namcho/PFC2k5W/Power/power_module.kicad_pcb

## KiCad design Power/power_module.kicad_pcb (2018-06-28)

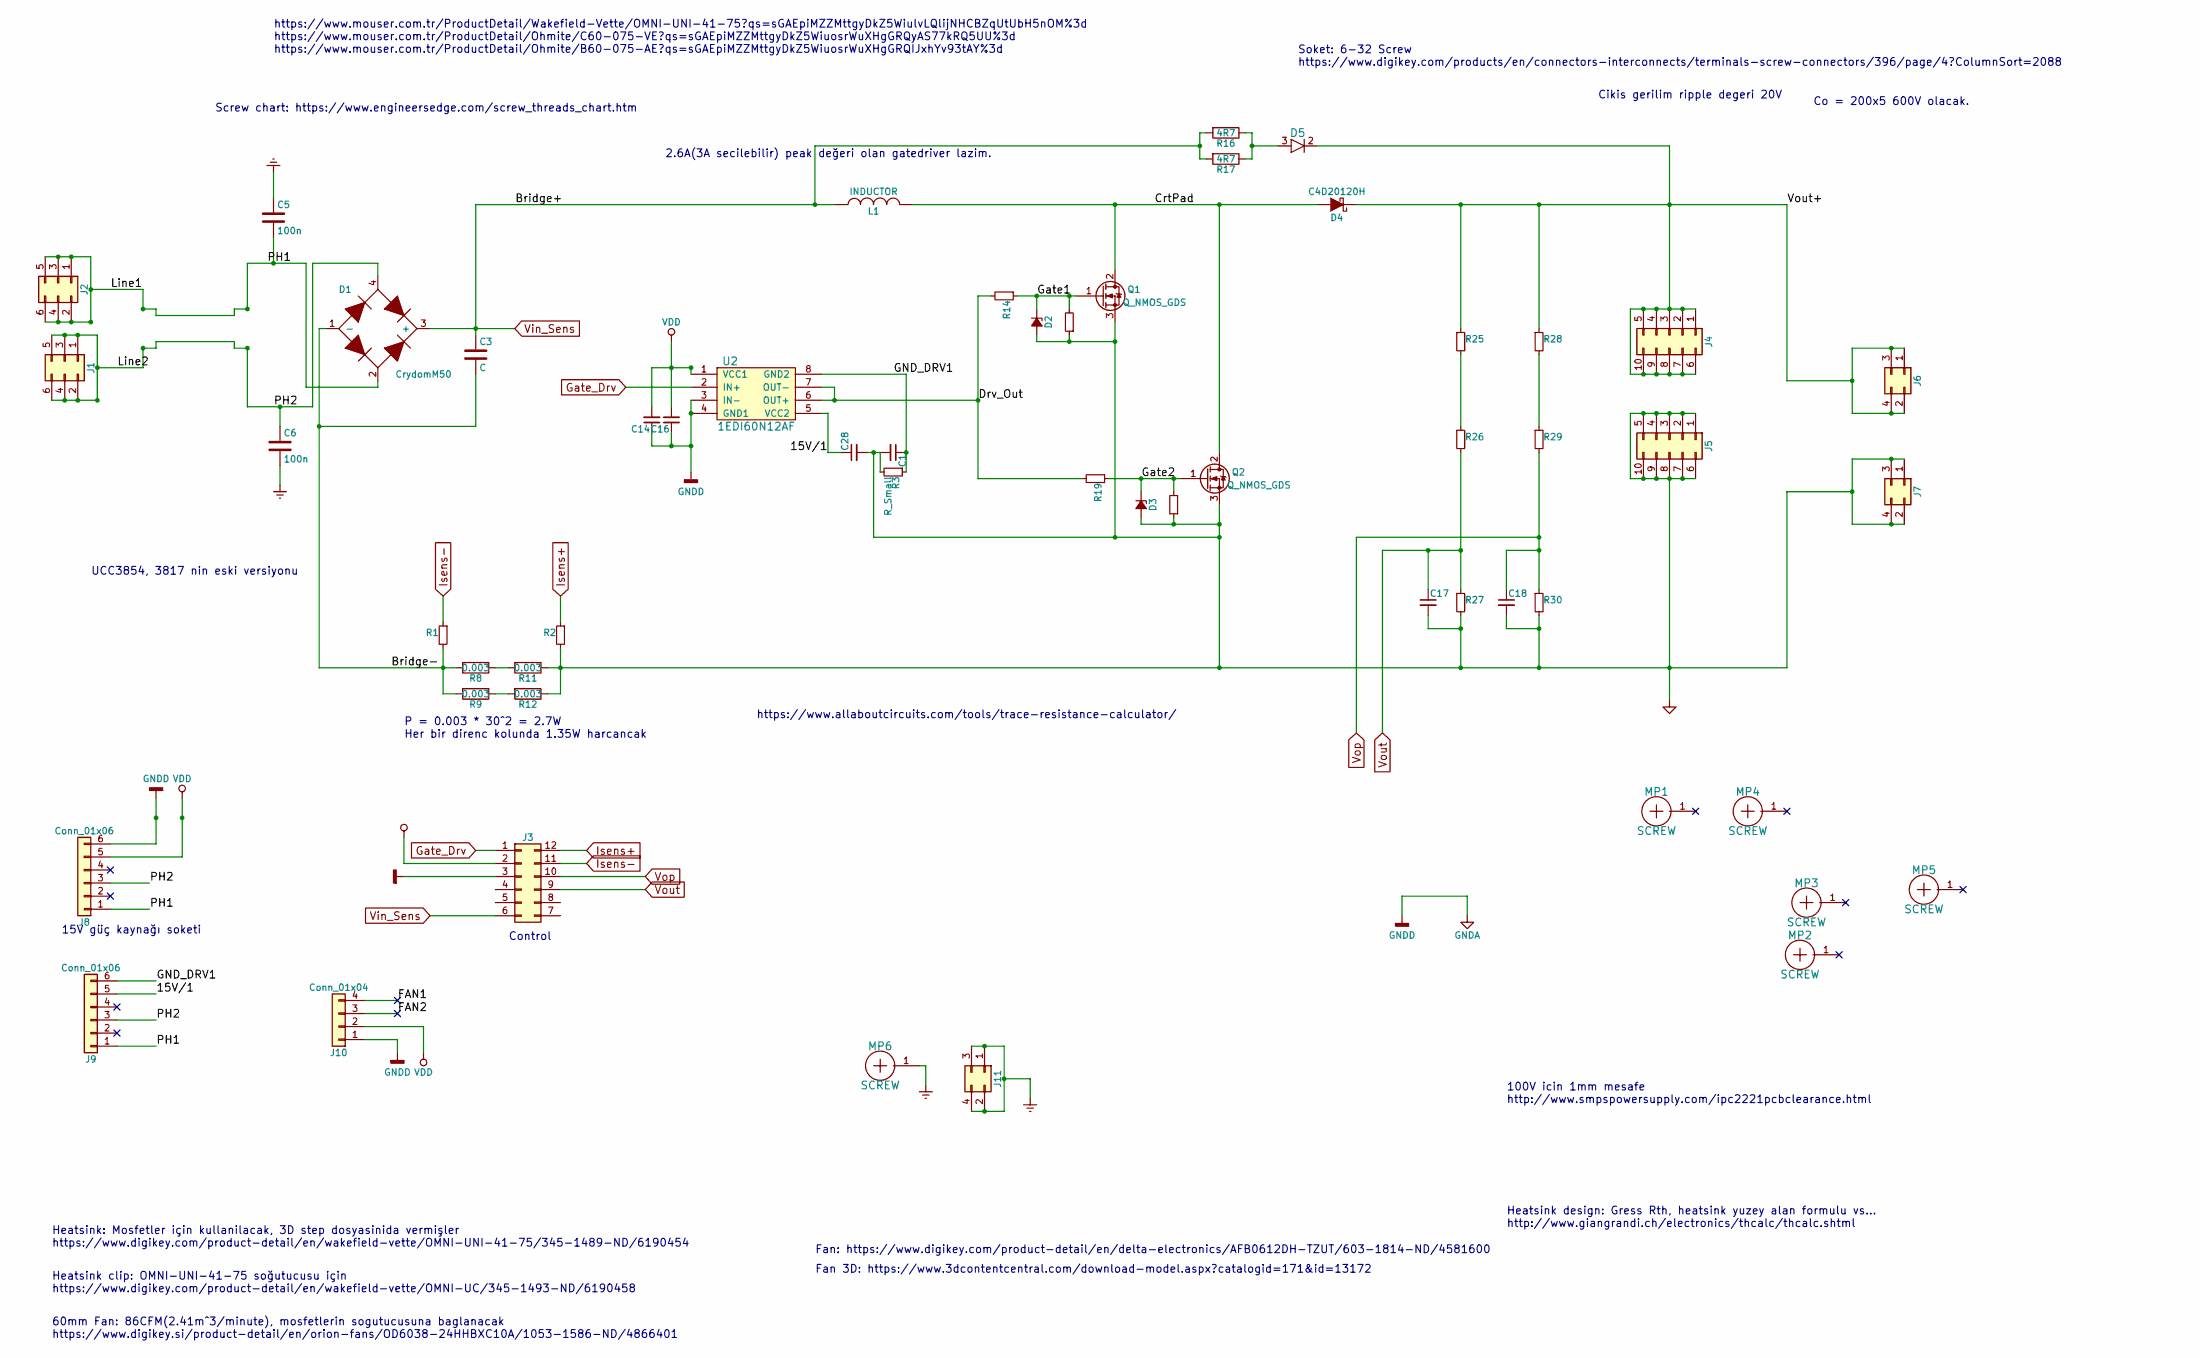
[picture p1: schematic power_module.sch]

Parts:
C1, C16, C28: 1u; C_1206_HandSoldering
C3: C; C_Rect_L18.0mm_W5.0mm_P15.00mm_FKS3_FKP3
C5, C6: 100n; C_Rect_L18.0mm_W8.0mm_P15.00mm_FKS3_FKP3
C14: 10n; C_0805_HandSoldering
C17, C18: C_Small; C_0805_HandSoldering
D1: CrydomM50; CrydomM50x_Fixed
D2, D3: D_Zener_Small_ALT; D_SOD-123
D4: C4D20120H; TO-247-2_Vertical
D5: IDW75E60; TO-247_TO-3P_Vertical
J1, J2: Conn_02x03_Odd_Even; Conn_6pins_30A
J3: Conn_02x06_Counter_Clockwise; Harwin_M55_6001242R
J4, J5: Conn_02x05_Top_Bottom; Hirose_FX30B_5P_DSA
J6, J7, J11: Conn_02x02_Odd_Even; Conn_4pins_15A
J8, J9: Conn_01x06; Pin_Header_Straight_1x06_Pitch2.54mm
J10: Conn_01x04; Pin_Header_Straight_1x04_Pitch2.54mm
L1: INDUCTOR; OD_77.80xID_39.34xHT_25.85_Vertical
MP1, MP2, MP3, MP4, MP5, MP6: SCREW; SCREW_3mm
Q1, Q2: Q_NMOS_GDS; TO-247_TO-3P_Vertical
R1, R2, R14, R19, R25, R26, R27, R28, R29, R30: R_Small; R_1206_HandSoldering
R3: R_Small; R_0805_HandSoldering
R8, R9, R11, R12: 0.003; R_2512_HandSoldering
R16, R17: 4R7; R_2512_HandSoldering
R31, R32: 10k; R_1206_HandSoldering
U2: 1EDI60N12AF; SOIC-8_3.9x4.9mm_Pitch1.27mm

Connections:
/15V/1: C28.1, J9.5, U2.5 (VCC2)
/Bridge-: C3.2, D1.1 (-), R1.2, R8.2, R9.2
/CrtPad: D4.2 (A), L1.1, Q1.2 (D), Q2.2 (D)
/Drv_Out: R14.2, R19.2, U2.6 (OUT+), U2.7 (OUT-)
/FAN1: J10.4
/FAN2: J10.3
/GND_DRV1: C1.1, J9.6, R3.1, U2.8 (GND2)
/Gate1: D2.1 (K), Q1.1 (G), R14.1, R31.2
/Gate2: D3.1 (K), Q2.1 (G), R19.1, R32.2
/Line1: C5.2, D1.2, J2.1, J2.2, J2.3, J2.4, J2.5, J2.6, J8.1, J9.1
/Line2: C6.1, D1.4, J1.1, J1.2, J1.3, J1.4, J1.5, J1.6, J8.3, J9.3
/Vout+: D4.1 (K), D5.2, J4.1, J4.2, J4.3, J4.4, J4.5, J4.6, J4.7, J4.8, J4.9, J4.10, J6.1, J6.2, J6.3, J6.4, R25.1, R28.1
Earth: C5.1, C6.2, J11.1, J11.2, J11.3, J11.4, MP6.1
GNDA: C1.2, C14.1, C16.1, C17.2, C18.2, C28.2, D2.2 (A), D3.2 (A), J3.3, J5.1, J5.2, J5.3, J5.4, J5.5, J5.6, J5.7, J5.8, J5.9, J5.10, J7.1, J7.2, J7.3, J7.4, J8.6, J10.1, Q1.3 (S), Q2.3 (S), R2.2, R3.2, R11.1, R12.1, R27.2, R30.2, R31.1, R32.1, U2.3 (IN-), U2.4 (GND1)
Gate_Drv: J3.1, U2.2 (IN+)
Isens+: J3.12, R2.1
Isens-: J3.11, R1.1
unnamed: D5.3, R16.1, R17.1
unnamed: R8.1, R11.2
unnamed: R9.1, R12.2
unnamed: R25.2, R26.1
unnamed: R28.2, R29.1
VDD: C14.2, C16.2, J3.2, J8.5, J10.2, U2.1 (VCC1)
Vin_Sens: C3.1, D1.3 (+), J3.6, L1.2, R16.2, R17.2
Vop: C18.1, J3.10, R29.2, R30.1
Vout: C17.1, J3.9, R26.2, R27.1

Notes on the sheet:
15V güç kaynağı soketi
Heatsink design: Gress Rth, heatsink yuzey alan formulu vs... http://www.giangrandi.ch/electronics/thcalc/thcalc.shtml
https://www.mouser.com.tr/ProductDetail/Wakefield-Vette/OMNI-UNI-41-75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 https://www.mouser.com.tr/ProductDetail/Ohmite/C60-075-VE?qs=sGAEpiMZZMttgyDkZ5WiuosrWuXHgGRQyAS77kRQ5UU%3d https://www.mouser.com.tr/ProductDetail/Ohmite/B60-075-AE?qs=sGAEpiMZZ…
60mm Fan: 86CFM(2.41m^3/minute), mosfetlerin sogutucusuna baglanacak https://www.digikey.si/product-detail/en/orion-fans/OD6038-24HHBXC10A/1053-1586-ND/4866401
Heatsink clip: OMNI-UNI-41-75 soğutucusu için https://www.digikey.com/product-detail/en/wakefield-vette/OMNI-UC/345-1493-ND/6190458
Heatsink: Mosfetler için kullanilacak, 3D step dosyasinida vermişler https://www.digikey.com/product-detail/en/wakefield-vette/OMNI-UNI-41-75/345-1489-ND/6190454
2.6A(3A secilebilir) peak değeri olan gatedriver lazim.
Screw chart: https://www.engineersedge.com/screw_threads_chart.htm
Fan: https://www.digikey.com/product-detail/en/delta-electronics/AFB0612DH-TZUT/603-1814-ND/4581600
Fan 3D: https://www.3dcontentcentral.com/download-model.aspx?catalogid=171&id=13172
Soket: 6-32 Screw https://www.digikey.com/products/en/connectors-interconnects/terminals-screw-connectors/396/page/4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
100V icin 1mm mesafe http://www.smpspowersupply.com/ipc2221pcbclearance.html
P = 0.003 * 30^2 = 2.7W Her bir direnc kolunda 1.35W harcancak
Cikis gerilim ripple degeri 20V
UCC3854, 3817 nin eski versiyonu
Co = 200x5 600V olacak.
Control
https://www.allaboutcircuits.com/tools/trace-resistance-calculator/

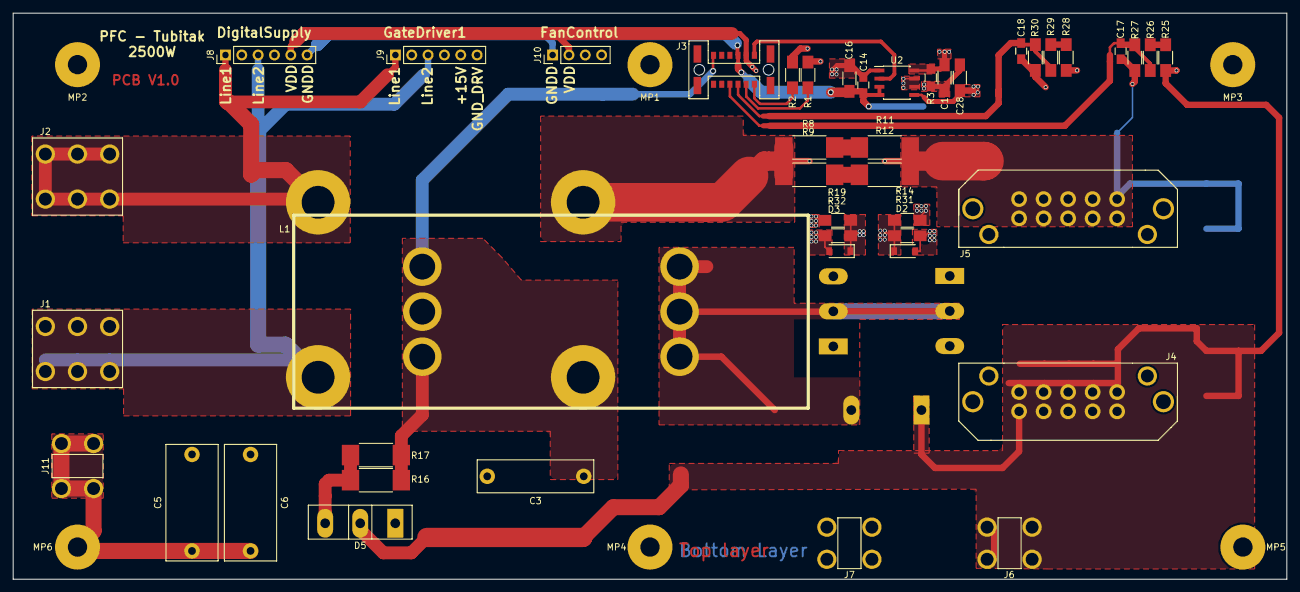
[picture p2: board power_module.kicad_pcb from above]

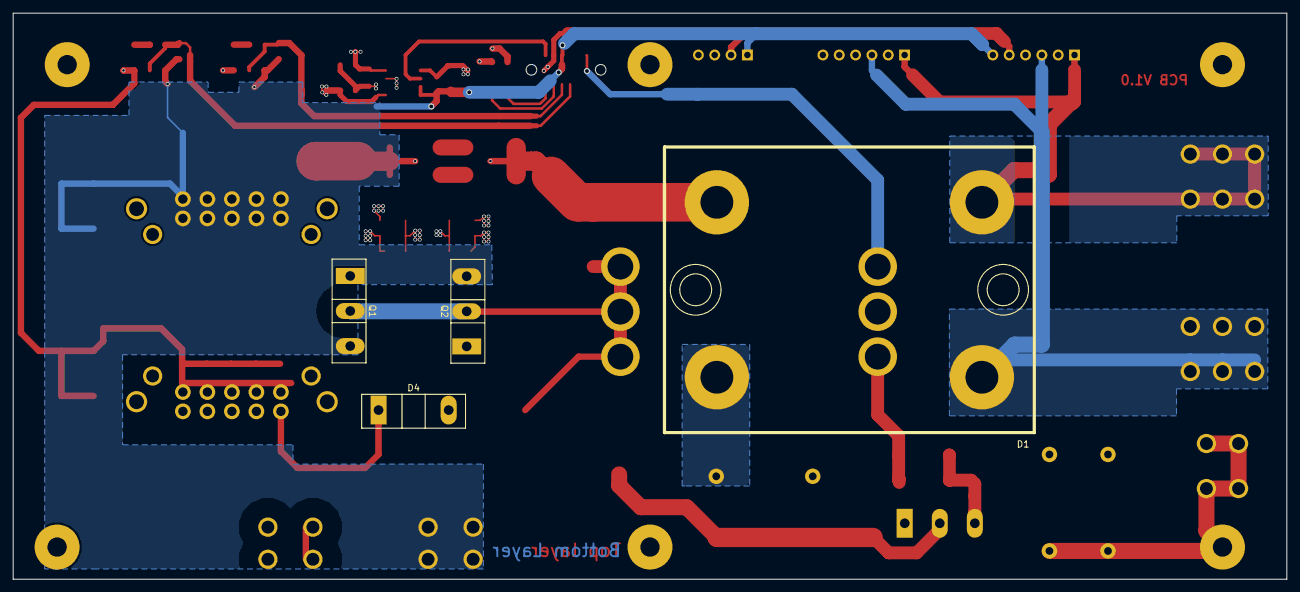
[picture p3: board power_module.kicad_pcb from below]

Board: 4 copper layers, 198.0 x 88.0 mm, 54 parts (4 on the bottom side), 24 nets.
