namcho/PFC2k5W/PFC2k5W.kicad_pcb

## KiCad design PFC2k5W.kicad_pcb (2018-05-13)

Schematic: PFC2k5W.sch

Parts:
C1, C13: 100u; CP_Elec_8x10
C2: 100n; C_0805_HandSoldering
C3: C; C_Rect_L10.0mm_W4.0mm_P7.50mm_MKS4
C4, C9: CP1_Small; C_1206_HandSoldering
C5, C6, C7, C8, C10, C11, C17, C18, C20: C_Small; C_0805_HandSoldering
C12, C16, C28: 1u; C_1206_HandSoldering
C14, C29: 10n; C_0805_HandSoldering
C15, C19: 250u; C_MKP_Vishay_70x65x57.5
D1: CrydomM50; CrydomM50x_Fixed
D2, D3: BAS40-00; SOT-23_Handsoldering
D4, D6, D8: ZENERsmall; D_SOD-123
D5: IDW75E60; TO-247_TO-3P_Vertical
D7: C5D50065D; TO-247_TO-3P_Vertical
L1: INDUCTOR_2; OD_77.80xID_39.34xHT_25.85_Horizantal
MP1, MP2, MP3, MP4, MP5, MP6: SCREW; SCREW_3mm
P1, P2: CONN_02X03; Conn_6pins_30A
P3, P6, P8: CONN_01X04; Pin_Header_Straight_1x04_Pitch2.54mm
P4, P5: CONN_02X02; Conn_4pins_15A
P7, P9: CONN_01X02; Pin_Header_Straight_1x02_Pitch2.54mm
Q1, Q2: Q_NMOS_GDS; TO-247_TO-3P_Vertical
Q3: IRF540N; TO-220
R1: 382k; R_1206_HandSoldering
R2: 383k; R_1206_HandSoldering
R3, R4, R5, R6, R7, R10, R13, R15, R20, R22, R23, R24, R33, R34, R35, R36, R37: R_Small; R_0805_HandSoldering
R8, R9, R11, R12: 0.003; R_2512_HandSoldering
R14, R19, R25, R26, R27, R28, R29, R30: R_Small; R_1206_HandSoldering
R16, R17: 4R7; R_2512_HandSoldering
R21: 0; R_0805_HandSoldering
R31, R32: 10k; R_1206_HandSoldering
U1: UCC3818; SOIC-16W_7.5x10.3mm_Pitch1.27mm
U2: 1EDI60N12AF; SOIC-8_3.9x4.9mm_Pitch1.27mm
U3: LM358N; SOIC-8-N

Connections:
+15V: C20.2, P7.2, P8.3, P9.1, R22.1, U3.8
/15V/1: C28.2, C29.2, P6.3, U2.5 (VCC2)
/Bridge+: C3.1, D1.3 (+), L1.1, L1.2, R1.2, R16.2, R17.2
/Bridge-: C3.2, D1.1 (-), R7.1, R8.2, R9.2, R37.2
/CrtPad: D7.3, L1.3, L1.4, Q1.3 (S), Q2.2 (D)
/Gate: D4.1, U1.16 (DRVOUT), U2.2 (IN+)
/PH1: D1.4, P2.1, P2.2, P2.3, P2.4, P2.5, P2.6, P3.2, P6.2, P8.2
/PH2: D1.2, P1.1, P1.2, P1.3, P1.4, P1.5, P1.6, P3.1, P6.1, P8.1
/Vout+: C15.1, C19.1, D5.2, D7.2, P4.1, P4.2, P4.3, P4.4, R25.1, R28.1
GNDA: C15.2, C17.2, C18.2, C19.2, C28.1, C29.1, D6.2, D8.2, P5.1, P5.2, P5.3, P5.4, P6.4, Q1.2 (D), Q2.3 (S), R5.2, R11.1, R12.1, R15.1, R27.2, R30.2, R31.1, R32.1, U2.8 (GND2)
GNDD: C1.2, C2.2, C4.2, C9.2, C10.1, C11.1, C12.2, C13.2, C14.1, C16.1, C20.1, D2.1 (A), D3.1 (A), D4.2, P3.4, P8.4, Q3.3, R3.2, R13.2, R15.2, R20.2, R33.1, R36.1, U1.1 (GND), U2.3 (IN-), U2.4 (GND1), U3.4
unnamed: C4.1, R3.1, U1.8 (VFF)
unnamed: C5.1, R4.1
unnamed: C5.2, C6.2, D2.3 (K), R37.1, U1.5 (MOUT)
unnamed: C6.1, R4.2, U1.3 (CAOUT)
unnamed: C7.1, R6.2, U1.7 (VAOUT)
unnamed: C8.1, R6.1
unnamed: C10.2, U1.13 (SS)
unnamed: C11.2, U1.14 (CT)
unnamed: C14.2, C16.2, U2.1 (VCC1)
unnamed: C17.1, R26.2, R27.1, U1.10 (OVP/EN)
unnamed: C7.2, C8.2, C18.1, R29.2, R30.1, U1.11 (VSENSE)
unnamed: D3.3 (K), R7.2, R10.1, U1.2 (PKLMT)
unnamed: D5.3, R16.1, R17.1
unnamed: D6.1, Q1.1 (G), R14.1, R31.2
unnamed: D8.1, Q2.1 (G), R19.1, R32.2
unnamed: P7.1, R20.1, U3.3
unnamed: P9.2, Q3.2
unnamed: Q3.1, R35.1, R36.2
unnamed: R1.1, R2.2
unnamed: R2.1, U1.6 (IAC)
unnamed: R5.1, U1.4 (CAI)
unnamed: R8.1, R11.2
unnamed: R9.1, R12.2
unnamed: R13.1, U1.12 (RT)
unnamed: R14.2, R19.2, U2.6 (OUT+), U2.7 (OUT-)
unnamed: R21.1, R23.1, U3.1
unnamed: R21.2, U3.2
unnamed: R22.2, R24.2, R33.2
unnamed: R23.2, R34.1, U3.5
unnamed: R24.1, U3.6
unnamed: R25.2, R26.1
unnamed: R28.2, R29.1
unnamed: R34.2, R35.2, U3.7
Vref: C9.1, R10.2, U1.9 (VREF)

Notes on the sheet:
12V güç kaynağı soketi
Heatsink design: Gress Rth, heatsink yuzey alan formulu vs... http://www.giangrandi.ch/electronics/thcalc/thcalc.shtml
https://www.mouser.com.tr/ProductDetail/Wakefield-Vette/OMNI-UNI-41-75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 https://www.mouser.com.tr/ProductDetail/Ohmite/C60-075-VE?qs=sGAEpiMZZMttgyDkZ5WiuosrWuXHgGRQyAS77kRQ5UU%3d https://www.mouser.com.tr/ProductDetail/Ohmite/B60-075-AE?qs=sGAEpiMZZ…
60mm Fan: 86CFM(2.41m^3/minute), mosfetlerin sogutucusuna baglanacak https://www.digikey.si/product-detail/en/orion-fans/OD6038-24HHBXC10A/1053-1586-ND/4866401
Heatsink clip: OMNI-UNI-41-75 soğutucusu için https://www.digikey.com/product-detail/en/wakefield-vette/OMNI-UC/345-1493-ND/6190458
Heatsink: Mosfetler için kullanilacak, 3D step dosyasinida vermişler https://www.digikey.com/product-detail/en/wakefield-vette/OMNI-UNI-41-75/345-1489-ND/6190454
Cikis kondasatorleri Panasonic 450V 390uF 30mmx45mm secildi.
2.6A(3A secilebilir) peak değeri olan gatedriver lazim.
Screw chart: https://www.engineersedge.com/screw_threads_chart.htm
Fan: https://www.digikey.com/product-detail/en/delta-electronics/AFB0612DH-TZUT/603-1814-ND/4581600
Fan 3D: https://www.3dcontentcentral.com/download-model.aspx?catalogid=171&id=13172
Soket: 6-32 Screw https://www.digikey.com/products/en/connectors-interconnects/terminals-screw-connectors/396/page/4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
100V icin 1mm mesafe http://www.smpspowersupply.com/ipc2221pcbclearance.html
Fan Kontrol
P = 0.003 * 30^2 = 2.7W Her bir direnc kolunda 1.35W harcancak
Cikis gerilim ripple degeri 20V
UCC3854, 3817 nin eski versiyonu
Co = 200x5 600V olacak.

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
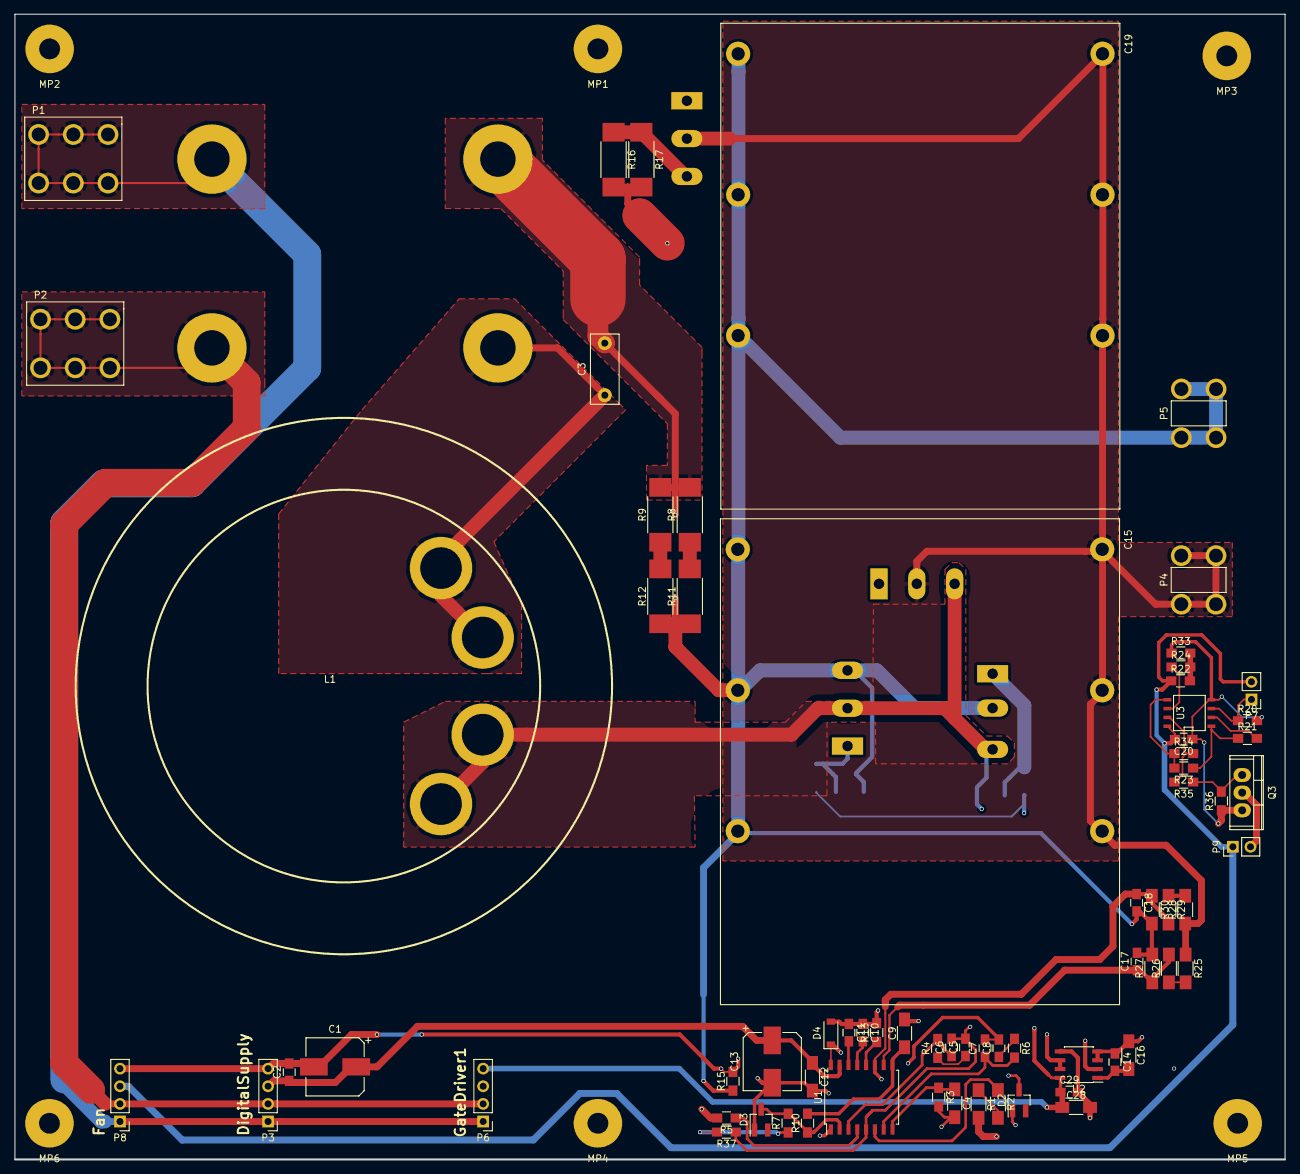
[picture p4: board PFC2k5W.kicad_pcb from above]

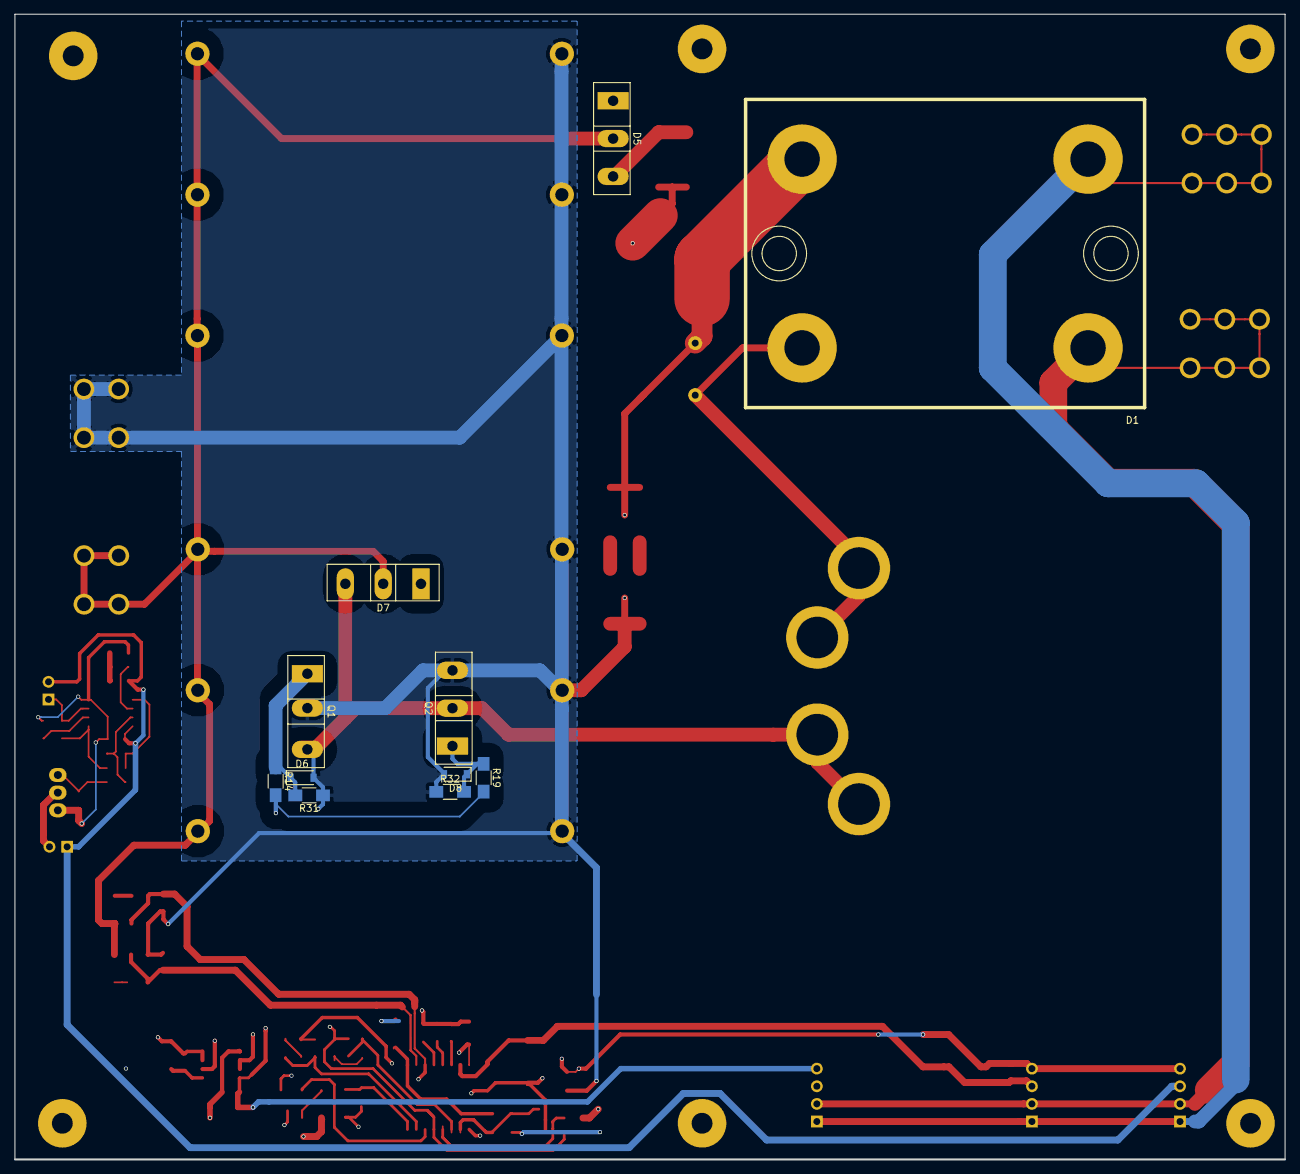
[picture p5: board PFC2k5W.kicad_pcb from below]

Board: 4 copper layers, 183.0 x 165.0 mm, 88 parts (11 on the bottom side), 46 nets.
