namcho/PFC2k5W/Control/control_module.kicad_pcb

## KiCad design Control/control_module.kicad_pcb (2018-06-28)

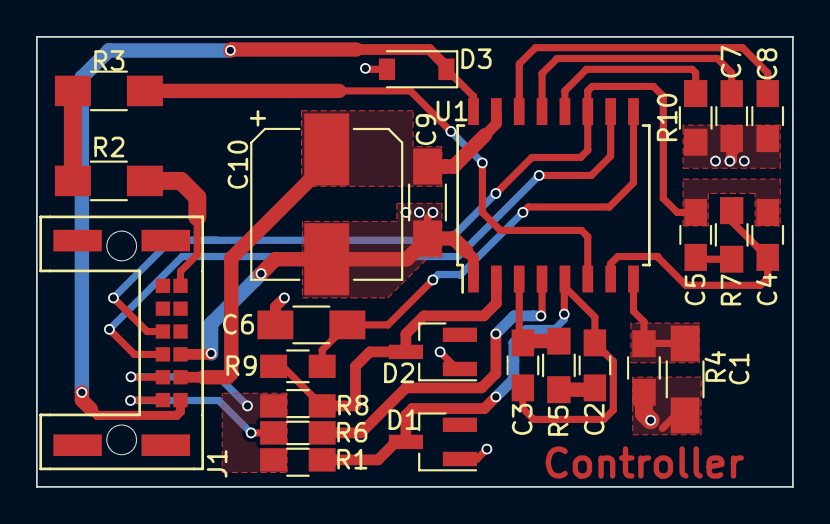
[picture p6: board control_module.kicad_pcb from above]

Board: 2 copper layers, 42.0 x 25.0 mm, 25 parts (0 on the bottom side), 22 nets.

Parts:
C1, C6: CP1_Small; C_1206_HandSoldering
C2, C3, C4, C5, C7, C8: C_Small; C_0805_HandSoldering
C9: 1u; C_1206_HandSoldering
C10: 100u; CP_Elec_8x10
D1, D2: BAS40-00; SOT-23_Handsoldering
D3: D_Zener_Small_ALT; D_SOD-123
J1: Conn_02x06_Counter_Clockwise; Harwin_M55_7101242R
R1, R4, R5, R6, R7, R8, R9, R10: R_Small; R_0805_HandSoldering
R2: 382k; R_1206_HandSoldering
R3: 383k; R_1206_HandSoldering
U1: UCC3818; SOIC-16W_7.5x10.3mm_Pitch1.27mm

Connections:
DriveOut: D3.1, J1.1, U1.16
GNDD: C1.2, C6.2, C7.1, C8.1, C9.2, C10.2, D1.1, D2.1, D3.2, J1.3, R4.2, R10.2, U1.1
Isens+: J1.12, R6.2
Isens-: J1.11, R1.2, R8.1
unnamed: C1.1, R4.1, U1.8
unnamed: C2.1, R5.1
unnamed: C2.2, C3.2, D1.3, R1.1, U1.5
unnamed: C3.1, R5.2, U1.3
unnamed: C4.1, R7.2, U1.7
unnamed: C5.1, R7.1
unnamed: C7.2, U1.13
unnamed: C8.2, U1.14
unnamed: D2.3, R8.2, R9.1, U1.2
unnamed: R2.1, R3.2
unnamed: R3.1, U1.6
unnamed: R6.1, U1.4
unnamed: R10.1, U1.12
VDD: C9.1, C10.1, J1.2, U1.15
Vinput: J1.6, R2.2
Vout: C4.2, C5.2, J1.9, U1.11
Vovp: J1.10, U1.10
Vref: C6.1, R9.2, U1.9
