namcho/PFC2k5W/(commit log)

2018-05-13 Guc kati semasi cizildi. Giristen cikisa dogru bir hat olacak sekilde layout yapildi.
    [PFC2k5W.kicad_pcb, PFC2k5W.sch, capacitor_module.kicad_pcb, capacitor_module.sch, control_module.kicad_pcb, control_module.sch, fancontroller.kicad_pcb, fancontroller.sch]
2018-05-13 Mevcut yerlesime gore kaba cizim yapildi.
    [power_module.kicad_pcb, power_module.sch]
2018-05-15 Guc akisindaki hat/poligonlar tamamlandi.
    [power_module.kicad_pcb, power_module.sch]
2018-05-16 Poligon eklemeleri yapildi. Hatlar iyilestirildi.
    [control_module.kicad_pcb, control_module.sch, power_module.kicad_pcb, power_module.sch]
2018-05-17 Kontrol karti semasi cizildi. Layout yerlestirme yapildi.
    [control_module.sch, power_module.kicad_pcb]
2018-05-18 Kontrolcu karti icin layout islemi tamamlandi.
    [control_module.kicad_pcb, control_module_backup.kicad_pcb]
2018-06-10 Güc kartina EMI filtresi eklendi. Güc kartindaki mosfet driver + ve - ile beslenebilecek sekilde duzenlendi. Güc ve kontrol kartlari icin BOM uretildi.
    [control_module_bom_.csv, control_module_bom_.xlsx, power_module.kicad_pcb, power_module.sch, power_module_bom_.csv, power_module_bom_.xlsx]
2018-06-25 Hatali Mosfet paketi duzeltildi. EMI filtre kaldirildi ve kart boyu kisaldi. TO247-2 paketli boost diyodu kullanildi.
    [control_module_bom_.xlsx, power_module.kicad_pcb, power_module.sch, power_module_bom_.xlsx]
2018-06-25 Mosfet konumlari degistirildi. Layout iyilestirme yapildi.
    [power_module.kicad_pcb]
2018-06-25 Layout iyilestirmesi. Cikis soketleri kartin sag alt kosesine alindi.
    [power_module.kicad_pcb]
2018-06-28 Yuksek akim tasiyan hatlara Mask atildi dolayisiyla bu hatlara lehim takviyesi yapilabilir.
    [power_module.kicad_pcb]
2018-06-28 Silk katmani duzenlendi. Gerber dosyalari uretildi.
    [power_module-B.Cu.gbl, power_module-B.Mask.gbs, power_module-B.SilkS.gbo, power_module-Edge.Cuts.gm1, power_module-F.Cu.gtl, power_module-F.Mask.gts, power_module-F.SilkS.gto, power_module.drl]
2018-06-28 Kontrol karti gerber dosyalari olusturuldu. Silk katmani duzenlendi.
    [control_module-B.Cu.gbl, control_module-B.Mask.gbs, control_module-B.SilkS.gbo, control_module-Edge.Cuts.gm1, control_module-F.Cu.gtl, control_module-F.Mask.gts, control_module-F.SilkS.gto, control_module.drl]
2018-06-28 Kontrol kartindaki duzenlemeler kayit edildi(Silk-layer).
    [control_module.kicad_pcb]
